jvsalo/leditaulu/misc/display_module.jpg

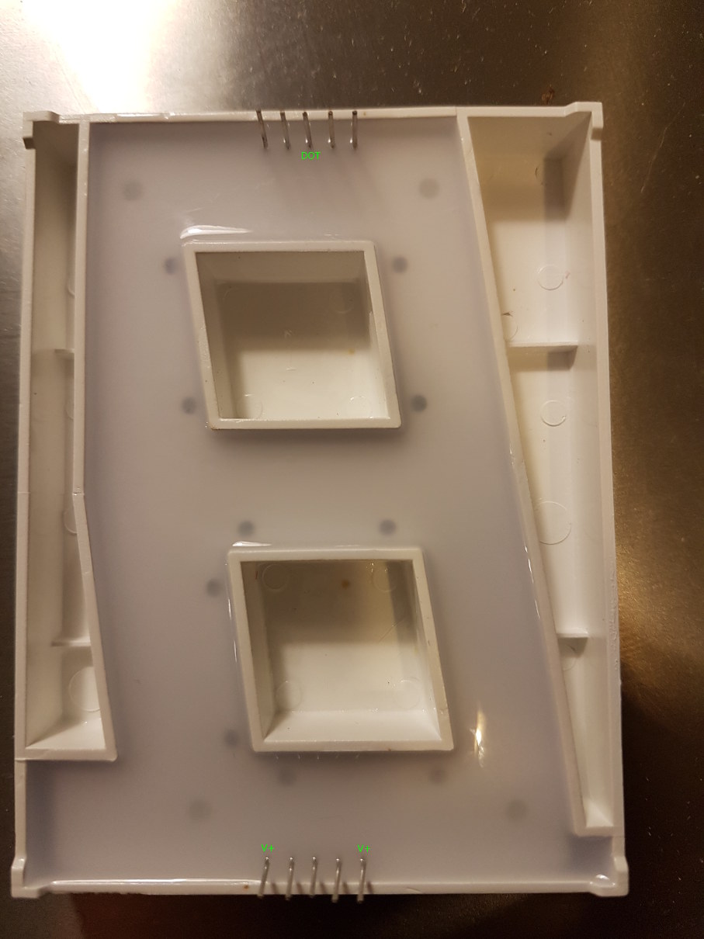
misc/display_module.jpg
