jvsalo/leditaulu/misc/bom.ods

Osa | Hinta | Kpl | Koodi | Linkki | Datasheet
Näyttö | 3 | 10 | 30101BS | https://www.aliexpress.com/item/FREE-SHIPPING-5PCS-LOT-3-inches-Red-30102BS-Common-Anode-Single-Digital-Tube/1326017867.html | http://www.oasistek.com/pdf/TOS-30101BS-B.pdf
Regulaattori 3v3 | 0.86 | 1 | LD1086D2M33TR | https://www.digikey.fi/product-detail/en/stmicroelectronics/LD1086D2M33TR/497-1223-1-ND/586223 | http://www.st.com/content/ccc/resource/technical/document/datasheet/53/db/00/58/09/98/4b/36/CD00001884.pdf/files/CD00001884.pdf/jcr:content/translations/en.CD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
LED-ohjain |  |  | TLC59116IPWR | https://www.digikey.fi/product-detail/en/texas-instruments/TLC59116IPWR/296-23354-1-ND/1835679 | http://www.ti.com/lit/ds/symlink/tlc59116.pdf
Mikrokontrolleri |  |  | ESP8266 ESP-12E
Radio |  | 1 | nRF24L01+
PCB |  | 1
Kondensaattori 1000 uF |  | 1
Kondensaattori 100 uF
Kondensaattori 10 uF
12V virtalähde |  | 1
Res 1K
Res 10K |  | 2
Flat ribbon cable | 3.14 | 3 | AWG28-10/G/300 | https://www.digikey.fi/product-detail/en/assmann-wsw-components/AWG28-10-G-300/AE10G-5-ND/686329 | http://www.assmann-wsw.com/fileadmin/datasheets/ASS_7306_CA.pdf
IDC male (PCB) 10-pin | 0.246 | 12 | 302-S101 | https://www.digikey.fi/product-detail/en/on-shore-technology-inc/302-S101/ED1543-ND/2178422 | http://www.on-shore.com/wp-content/uploads/2015/09/302-sxxx.pdf
IDC female (cable) 10-pin | 0.295 | 12 | 3030-10-0102-00 | https://www.digikey.fi/product-detail/en/cnc-tech/3030-10-0102-00/1175-1435-ND/3821479 | http://www.cnctech.us/pdfs/3030-XX-0102-00.pdf
0.1” female (cable) 5-pin | 0.268 | 25 | 3-643813-5 | https://www.digikey.fi/product-detail/en/te-connectivity-amp-connectors/3-643813-5/A31109-ND/698295 | http://www.te.com/commerce/DocumentDelivery/DDEController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
Zener overvoltage protection | 0.61 | 1 | SMBJ5363B-TP | https://www.digikey.fi/product-detail/en/micro-commercial-co/SMBJ5363B-TP/SMBJ5363B-TPMSCT-ND/1636229 | http://www.mccsemi.com/up_pdf/SMBJ5338B-SMBJ5388B(SMB).pdf
Schottky rev. polarity protection | 0.31 | 1 | MBR230LSFT1G | https://www.digikey.fi/product-detail/en/on-semiconductor/MBR230LSFT1G/MBR230LSFT1GOSCT-ND/1967064 | http://www.onsemi.com/pub_link/Collateral/MBR230LSFT1-D.PDF
Fuse | 0.52 | 1 | ERB-RE2R50V | https://www.digikey.fi/product-detail/en/panasonic-electronic-components/ERB-RE2R50V/P15119CT-ND/2796826 | https://industrial.panasonic.com/cdbs/www-data/pdf/AFA0000/AFA0000C7.pdf
