jvsalo/leditaulu/kicad/leditaulu.kicad_pcb

## KiCad design kicad/leditaulu.kicad_pcb (2017-05-01)

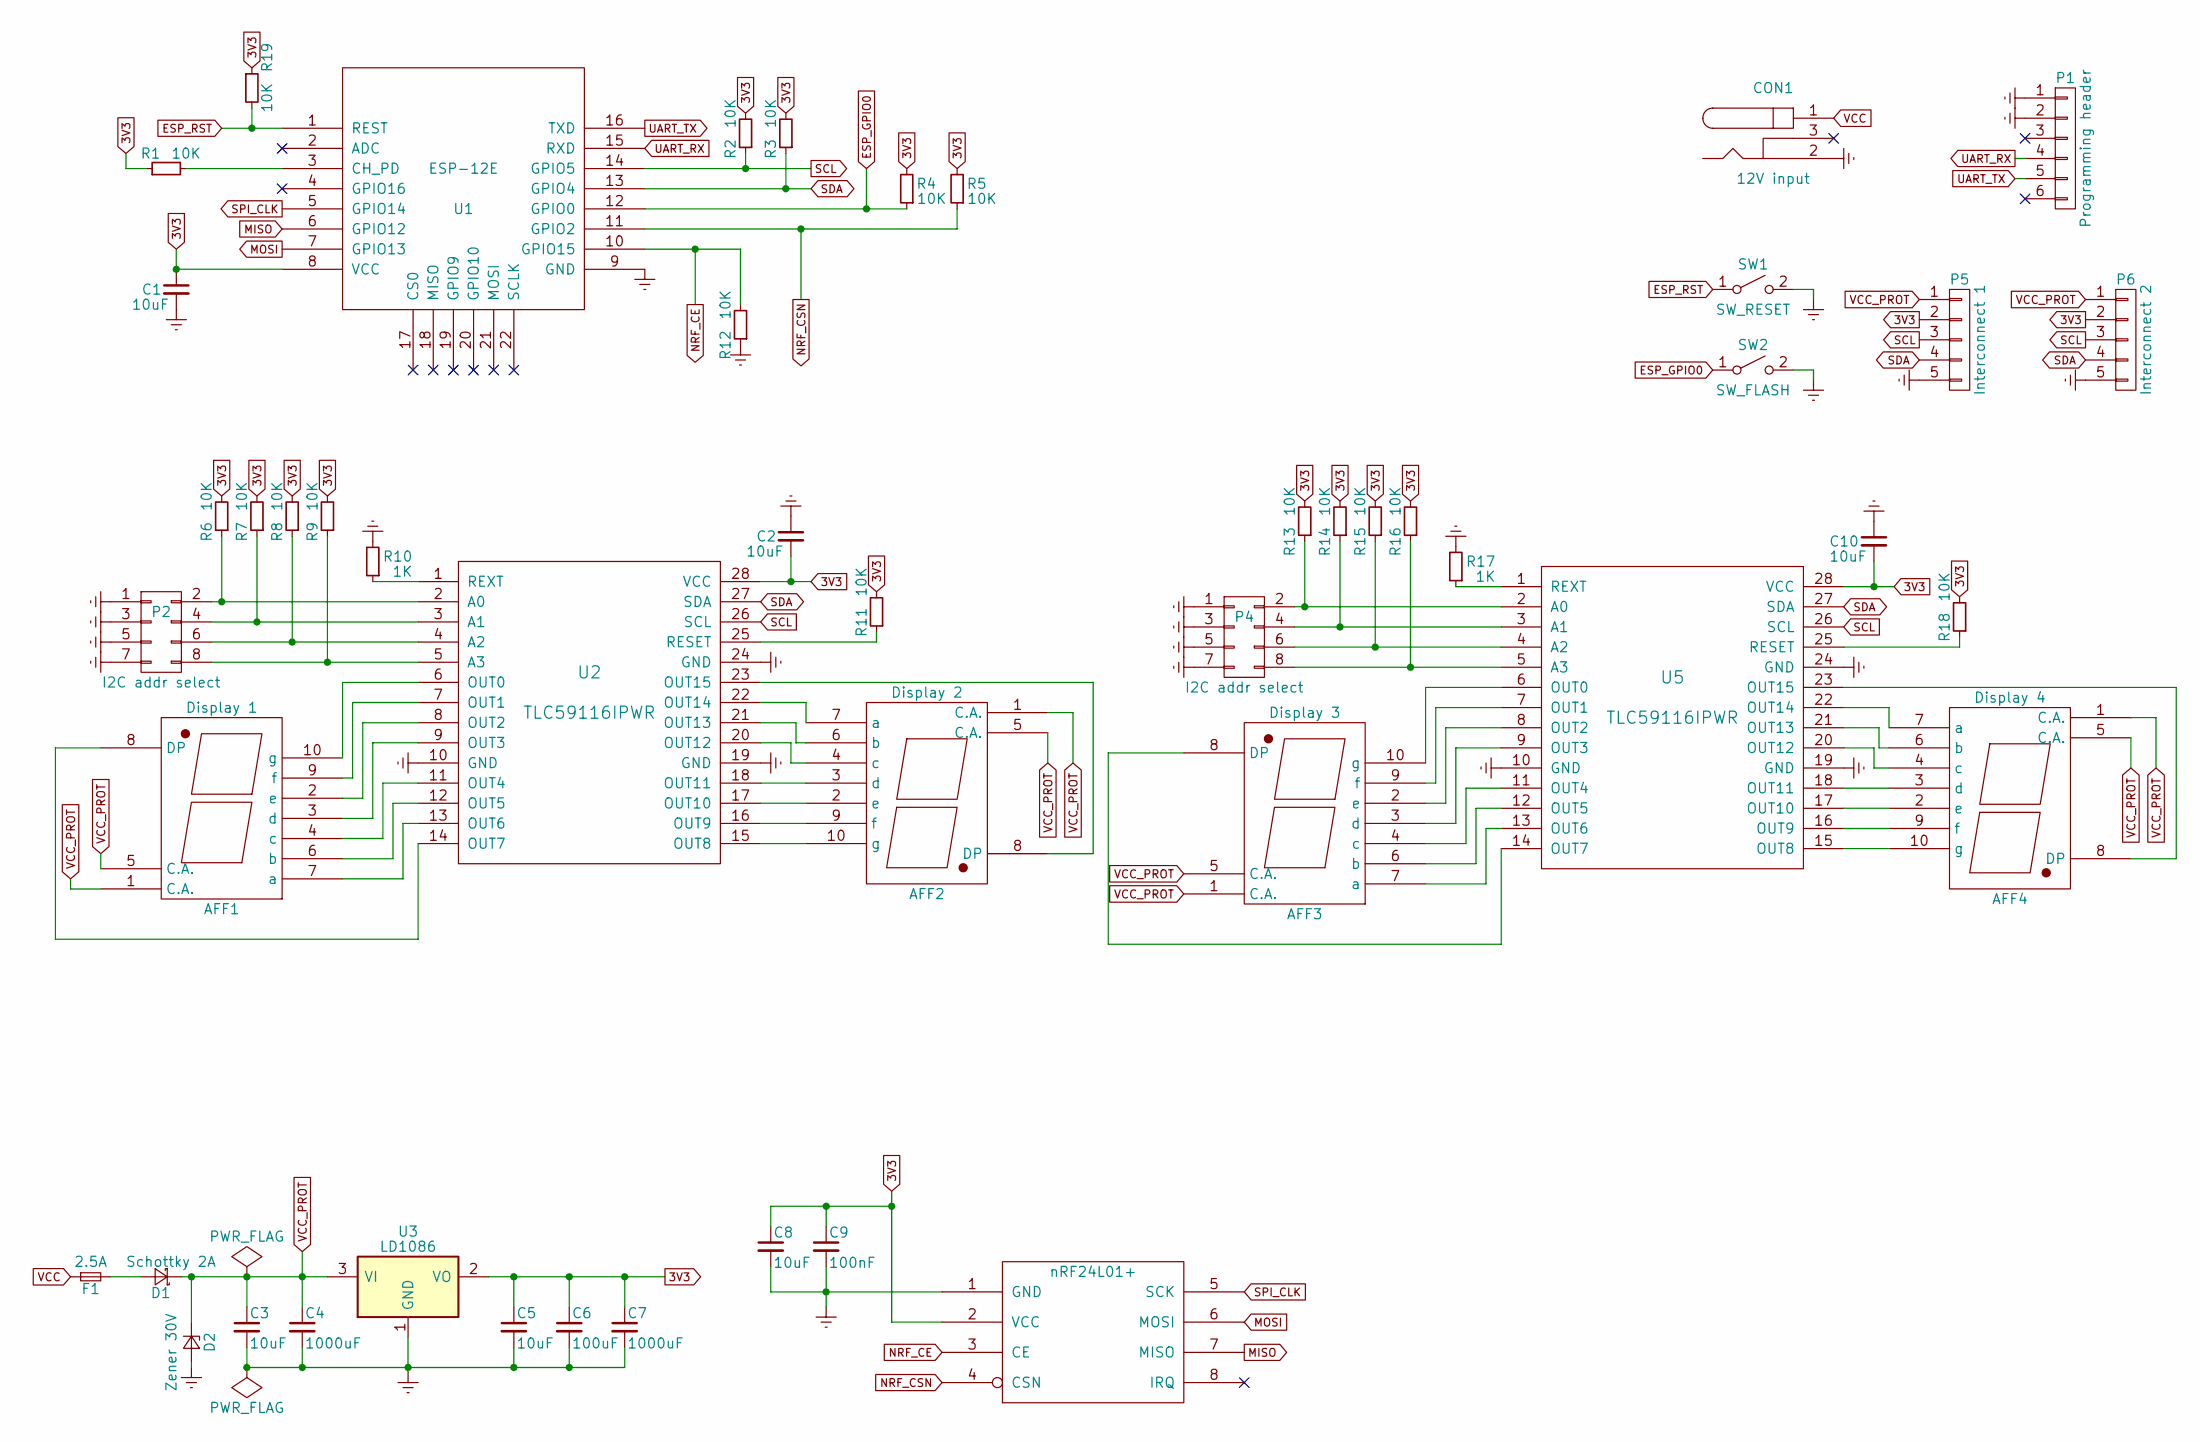
[picture p2: schematic leditaulu.sch, Snooker display]

Parts:
AFF1: Display 1; IDC_Header_Straight_10pins
AFF2: Display 2; IDC_Header_Straight_10pins
AFF3: Display 3; IDC_Header_Straight_10pins
AFF4: Display 4; IDC_Header_Straight_10pins
C1, C2, C3, C5, C8, C10: 10uF; C_1206_HandSoldering
C4, C7: 1000uF; CP_Radial_D10.0mm_P5.00mm
C6: 100uF; C_1206_HandSoldering
C9: 100nF; C_1206_HandSoldering
CON1: 12V input; BARREL_JACK
D1: Schottky 2A; D_SOD-123F
D2: Zener 30V; D_SMB_Handsoldering
F1: 2.5A; R_0603_HandSoldering
P1: Programming header; Pin_Header_Straight_1x06_Pitch2.54mm
P2, P4: I2C addr select; Pin_Header_Straight_2x04_Pitch2.54mm
P5: Interconnect 1; Pin_Header_Straight_1x05_Pitch2.54mm
P6: Interconnect 2; Pin_Header_Straight_1x05_Pitch2.54mm
R1, R2, R3, R4, R5, R6, R7, R8, R9, R11, R12, R13, R14, R15, R16, R18, R19: 10K; R_1206_HandSoldering
R10, R17: 1K; R_1206_HandSoldering
SW1: SW_RESET; SW_SPST_B3S-1000
SW2: SW_FLASH; SW_SPST_B3S-1000
U1: ESP-12E; ESP-12E_SMD
U2, U5: TLC59116IPWR; TSSOP-28_4.4x9.7mm_Pitch0.65mm
U3: LD1086; TO-263-3Lead
U4: nRF24L01+; NRF24L01

Connections:
3V3: C1.1, C2.2, C5.1, C6.1, C7.1, C8.1, C9.1, C10.2, P5.2, P6.2, R1.1, R2.2, R3.2, R4.2, R5.2, R6.2, R7.2, R8.2, R9.2, R11.2, R13.2, R14.2, R15.2, R16.2, R18.2, R19.1, U1.8 (VCC), U2.28 (VCC), U3.2 (VO), U4.2 (VCC), U5.28 (VCC)
ESP_GPIO0: R4.1, SW2.1 (A), U1.12 (GPIO0)
ESP_RST: R19.2, SW1.1 (A), U1.1 (REST)
Earth: C1.2, C2.1, C3.2, C4.2, C5.2, C6.2, C7.2, C8.2, C9.2, C10.1, CON1.2, D2.2 (A), P1.1, P1.2, P2.1, P2.3, P2.5, P2.7, P4.1, P4.3, P4.5, P4.7, P5.5, P6.5, R10.2, R12.1, R17.2, SW1.2 (B), SW2.2 (B), U1.9 (GND), U2.10 (GND), U2.19 (GND), U2.24 (GND), U3.1 (GND), U4.1 (GND), U5.10 (GND), U5.19 (GND), U5.24 (GND)
MISO: U1.6 (GPIO12), U4.7 (MISO)
MOSI: U1.7 (GPIO13), U4.6 (MOSI)
NRF_CE: R12.2, U1.10 (GPIO15), U4.3 (CE)
NRF_CSN: R5.1, U1.11 (GPIO2), U4.4 (CSN)
unnamed: AFF1.2 (e), U2.8 (OUT2)
unnamed: AFF1.3 (d), U2.9 (OUT3)
unnamed: AFF1.4 (c), U2.11 (OUT4)
unnamed: AFF1.6 (b), U2.12 (OUT5)
unnamed: AFF1.7 (a), U2.13 (OUT6)
unnamed: AFF1.8 (DP), U2.14 (OUT7)
unnamed: AFF1.9 (f), U2.7 (OUT1)
unnamed: AFF1.10 (g), U2.6 (OUT0)
unnamed: AFF2.2 (e), U2.17 (OUT10)
unnamed: AFF2.3 (d), U2.18 (OUT11)
unnamed: AFF2.4 (c), U2.20 (OUT12)
unnamed: AFF2.6 (b), U2.21 (OUT13)
unnamed: AFF2.7 (a), U2.22 (OUT14)
unnamed: AFF2.8 (DP), U2.23 (OUT15)
unnamed: AFF2.9 (f), U2.16 (OUT9)
unnamed: AFF2.10 (g), U2.15 (OUT8)
unnamed: AFF3.2 (e), U5.8 (OUT2)
unnamed: AFF3.3 (d), U5.9 (OUT3)
unnamed: AFF3.4 (c), U5.11 (OUT4)
unnamed: AFF3.6 (b), U5.12 (OUT5)
unnamed: AFF3.7 (a), U5.13 (OUT6)
unnamed: AFF3.8 (DP), U5.14 (OUT7)
unnamed: AFF3.9 (f), U5.7 (OUT1)
unnamed: AFF3.10 (g), U5.6 (OUT0)
unnamed: AFF4.2 (e), U5.17 (OUT10)
unnamed: AFF4.3 (d), U5.18 (OUT11)
unnamed: AFF4.4 (c), U5.20 (OUT12)
unnamed: AFF4.6 (b), U5.21 (OUT13)
unnamed: AFF4.7 (a), U5.22 (OUT14)
unnamed: AFF4.8 (DP), U5.23 (OUT15)
unnamed: AFF4.9 (f), U5.16 (OUT9)
unnamed: AFF4.10 (g), U5.15 (OUT8)
unnamed: D1.2 (A), F1.2
unnamed: P2.2, R6.1, U2.2 (A0)
unnamed: P2.4, R7.1, U2.3 (A1)
unnamed: P2.6, R8.1, U2.4 (A2)
unnamed: P2.8, R9.1, U2.5 (A3)
unnamed: P4.2, R13.1, U5.2 (A0)
unnamed: P4.4, R14.1, U5.3 (A1)
unnamed: P4.6, R15.1, U5.4 (A2)
unnamed: P4.8, R16.1, U5.5 (A3)
unnamed: R1.2, U1.3 (CH_PD)
unnamed: R10.1, U2.1 (REXT)
unnamed: R11.1, U2.25 (RESET)
unnamed: R17.1, U5.1 (REXT)
unnamed: R18.1, U5.25 (RESET)
SCL: P5.3, P6.3, R2.1, U1.14 (GPIO5), U2.26 (SCL), U5.26 (SCL)
SDA: P5.4, P6.4, R3.1, U1.13 (GPIO4), U2.27 (SDA), U5.27 (SDA)
SPI_CLK: U1.5 (GPIO14), U4.5 (SCK)
UART_RX: P1.4, U1.15 (RXD)
UART_TX: P1.5, U1.16 (TXD)
VCC: CON1.1, F1.1
VCC_PROT: AFF1.1 (C.A.), AFF1.5 (C.A.), AFF2.1 (C.A.), AFF2.5 (C.A.), AFF3.1 (C.A.), AFF3.5 (C.A.), AFF4.1 (C.A.), AFF4.5 (C.A.), C3.1, C4.1, D1.1 (K), D2.1 (K), P5.1, P6.1, U3.3 (VI)

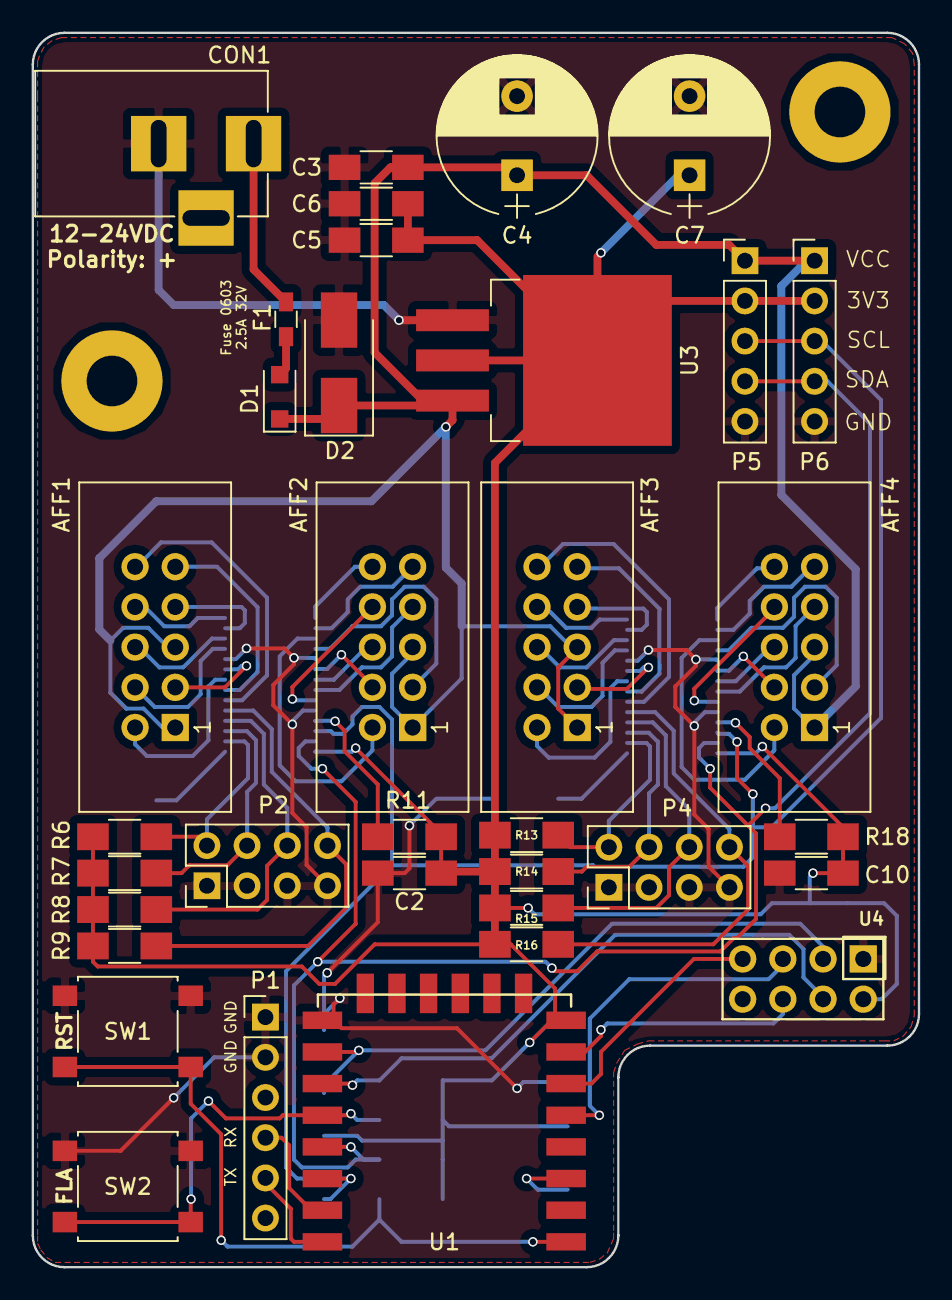
[picture p3: board leditaulu.kicad_pcb from above]

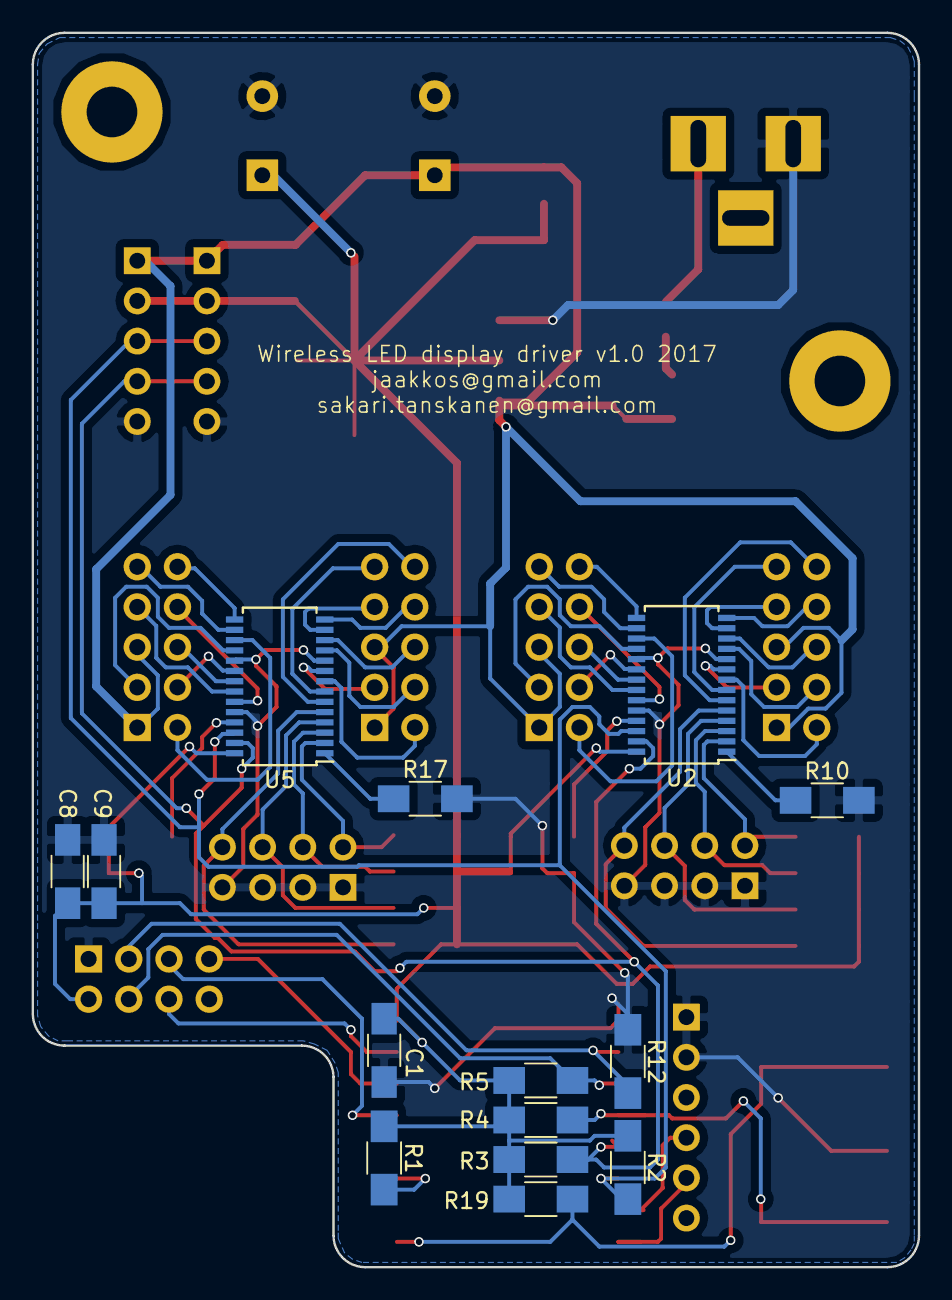
[picture p4: board leditaulu.kicad_pcb from below]

Board: 2 copper layers, 56.0 x 78.0 mm, 49 parts (14 on the bottom side), 61 nets.
