jvsalo/leditaulu/src/scoreboard/constants.h

#ifndef __SCOREBOARD_CONSTANTS_H__
#define __SCOREBOARD_CONSTANTS_H__


/* SWITCHES */
#define SW_COUNT 10
/* Remote button index */
#define SW_2   0
#define SW_3   1
#define SW_4_L 2
#define SW_4_R 3
#define SW_5   4
#define SW_6   5
#define SW_7   6
#define SW_8   7
#define SW_9   8
#define SW_10  9

#define BTN_ADD_1 SW_6
#define BTN_ADD_2 SW_10
#define BTN_ADD_3 SW_2
#define BTN_ADD_4 SW_3
#define BTN_ADD_5 SW_7
#define BTN_ADD_6 SW_8
#define BTN_ADD_7 SW_9
#define BTN_TO_A  SW_4_R
#define BTN_TO_B  SW_4_L
#define BTN_RST SW_5
/* END SWITCHES */

/* DISPLAYS */
#define DISPLAY_COUNT 10

#define DISP_A_SCORE_0 9
#define DISP_A_SCORE_1 10
#define DISP_A_SCORE_2 8
#define DISP_A_SET 11

#define DISP_B_SCORE_0 6
#define DISP_B_SCORE_1 7
#define DISP_B_SCORE_2 5
#define DISP_B_SET 4

#define DISP_BREAK_0 1
#define DISP_BREAK_1 0

/* END DISPLAYS */ 

#endif /* __SCOREBOARD_CONSTANTS_H__ */
