jvsalo/leditaulu/(commit log)

2017-04-09 Initial import
    [bom.ods, leditaulu.kicad_pcb, leditaulu.sch]
2017-04-09 Started schematic; reorganize dirs
    [bom.ods, leditaulu.kicad_pcb, leditaulu.sch]
2017-04-09 Add 3V3 regulator to BOM
    [bom.ods]
2017-04-09 Add regulator datasheet to BOM
    [bom.ods]
2017-04-11 Continue schematic
    [leditaulu.sch]
2017-04-11 Add nRF24L01+
    [leditaulu.sch]
2017-04-26 Finish schematic and footprint associations
    [leditaulu.sch]
2017-04-27 Start routing
    [leditaulu.kicad_pcb, leditaulu.sch]
2017-04-27 Add buttons, continue routing
    [leditaulu.kicad_pcb, leditaulu.sch]
2017-04-27 Fix submodules (ESP8266)
    [leditaulu.sch]
2017-04-28 Finish routing
    [leditaulu.kicad_pcb, leditaulu.sch]
2017-04-29 Add power supply protection; misc. fixes
    [bom.ods, leditaulu.kicad_pcb, leditaulu.sch]
2017-05-01 Version 1.0
    [leditaulu.kicad_pcb, leditaulu.sch]
2017-10-02 Fix issues with circular buffer
    [circular_buffer.h]
2017-10-02 Add remote/board shared constants to constants.h
2017-10-02 Remote command handling and web server
    - Modify scoreboard state with remote commands
    - Serve web page that displays current score
2017-10-05 Fix strict aliasing violation
    [flashmem.cpp, flashmem.h]
